MatthewBoeding/GPSboard/README.md

# GPS Board v3.0 r1.1

This board was designed for ECEN-435 at the University of Nebraska-Lincoln (Scott Campus).

## Connections

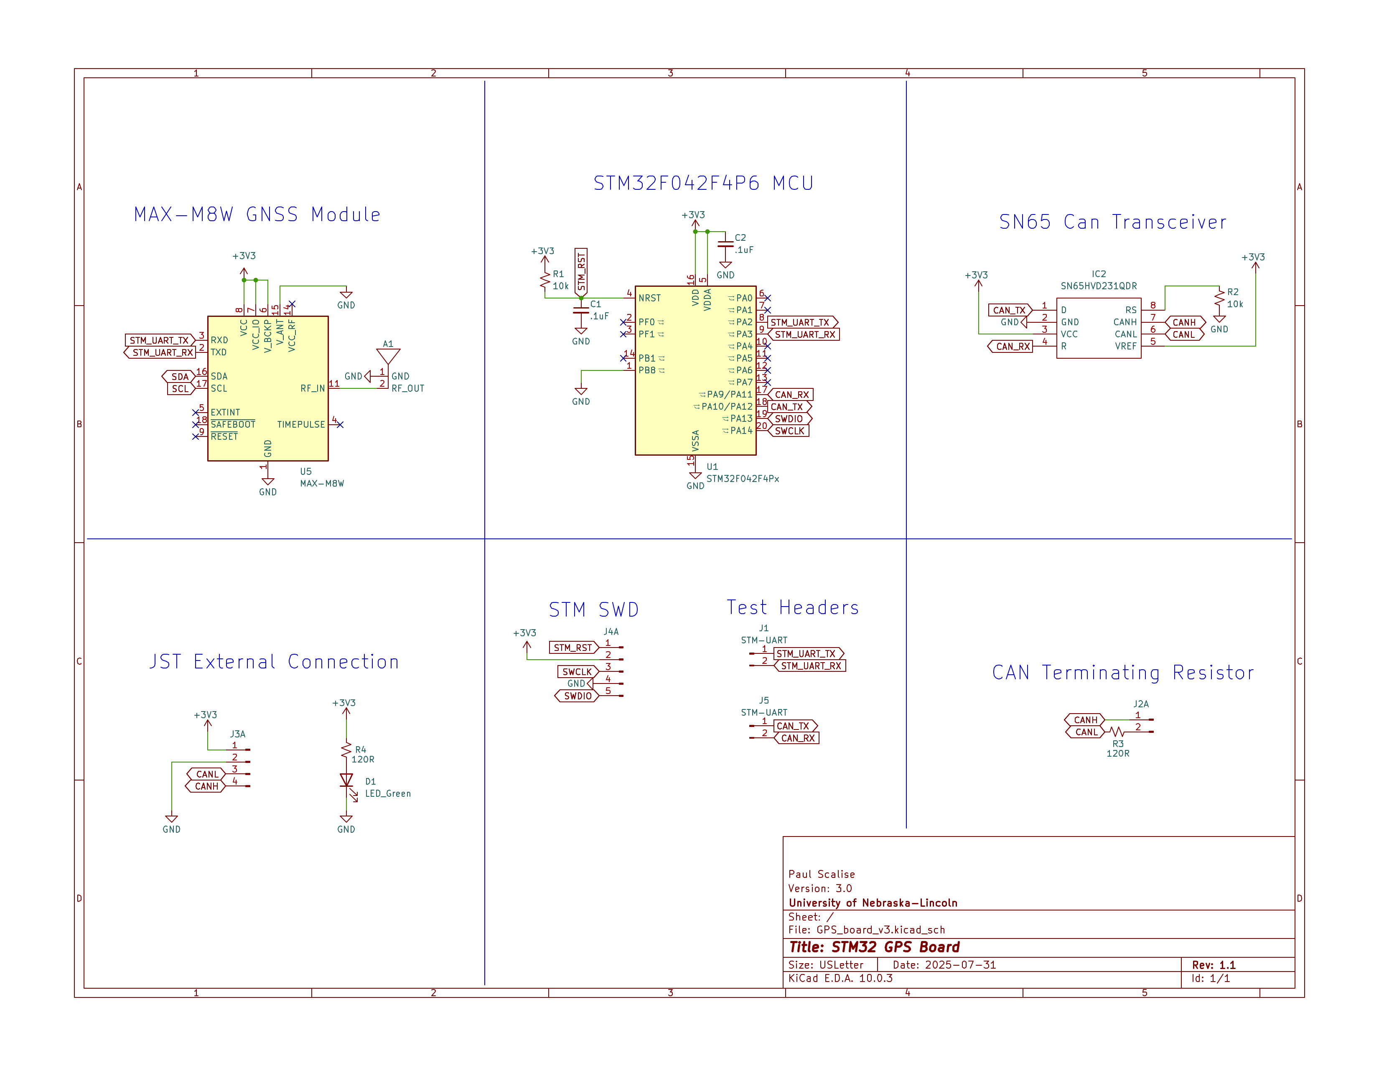
[picture p1: assets/sch.png]
schematic


## Board

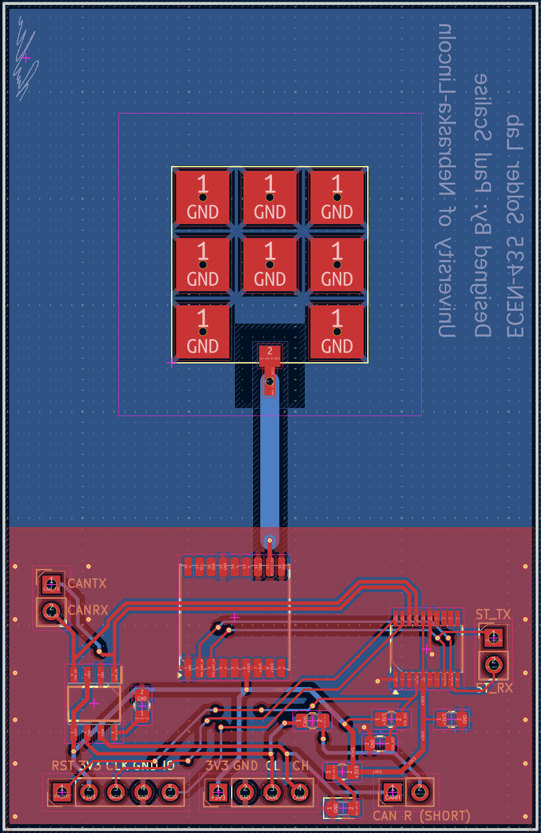
[picture p2: assets/board.png]
board


## Issues and Troubleshooting
Testing is underway with more updates to come.
