MatthewBoeding/GPSboard/Version2.0/README.md

# GPS Board V2.0
This board was designed for ECEN-4350 at the University of Nebraska-Lincoln (Scott Campus), so I will not be updating once completed. 
If a new design is required in the future, I will place it here. 
R1-R3 = 1kΩ, L2 = 5.6nH, C1 = 0Ω, C2 = 1.8 pF, C3 = 1µF

## Connections
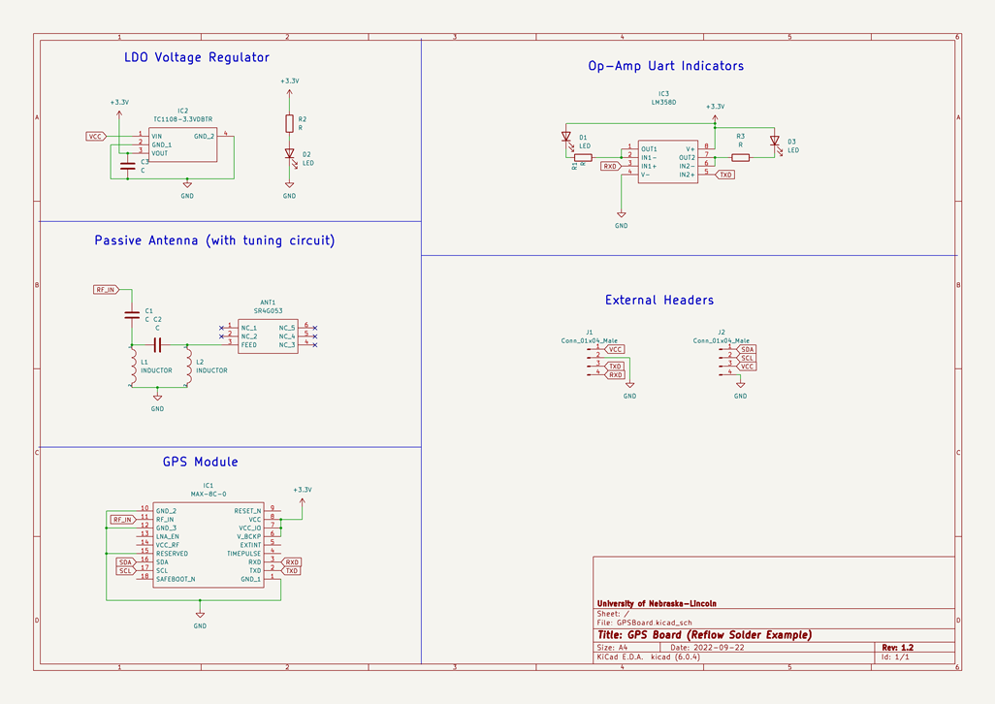
[picture p3: Version2.0/gps.schematic.png]
Schematic


## Issues and Troubleshooting
Version 1.0 board had issues with CAN communication. If this design is reused, will need to add on an LDO and allow for 5.0V to troubleshoot CAN transmission errors.
