MatthewBoeding/GPSboard/Hardware Design/GPS_board_v3.kicad_pcb

## KiCad design Hardware Design/GPS_board_v3.kicad_pcb (2026-06-24)

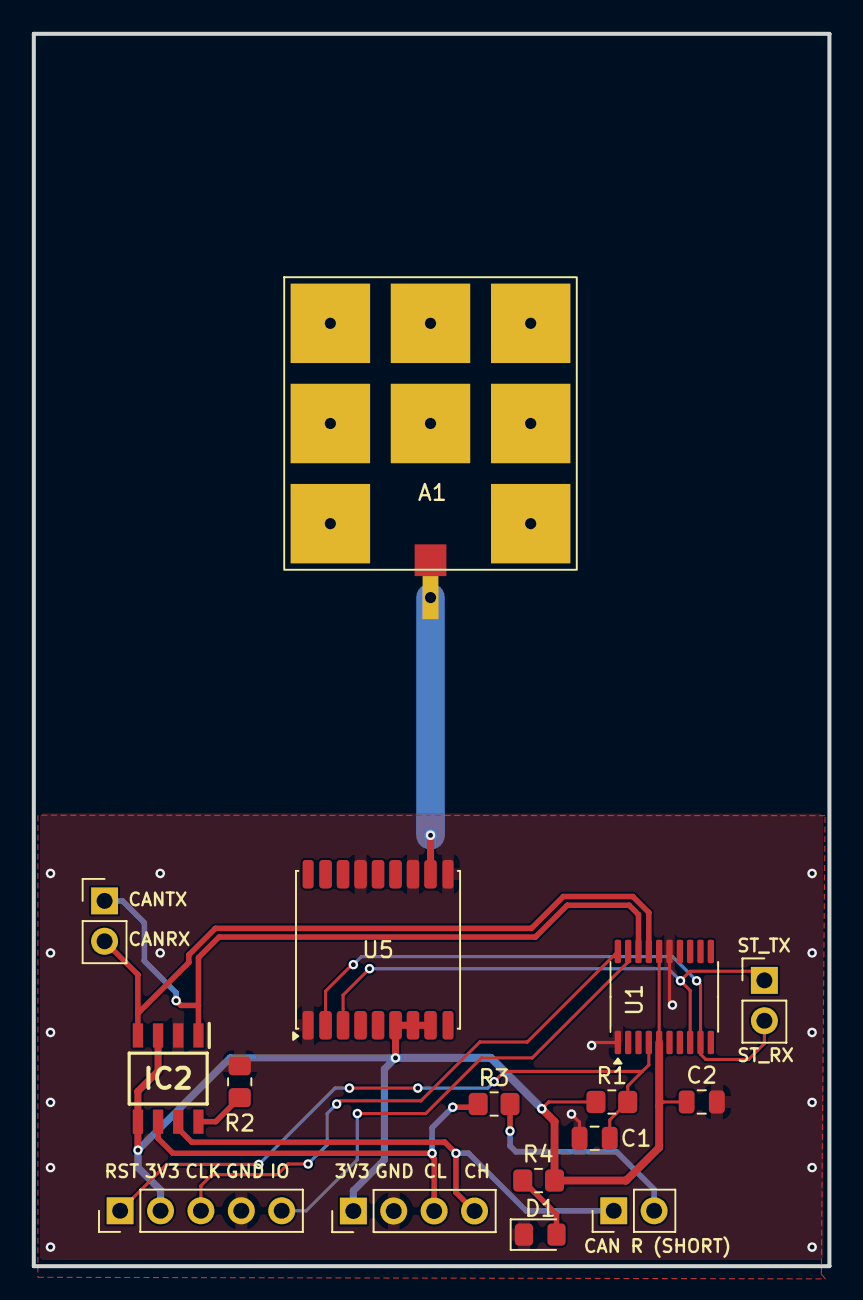
[picture p5: board GPS_board_v3.kicad_pcb from above]

Board: 2 copper layers, 50.0 x 77.5 mm, 16 parts (0 on the bottom side), 15 nets.

Parts:
A1: L000953-01
C1, C2: .1uF; C_0805_2012Metric
D1: LED_Green; LED_0805_2012Metric_Pad1.15x1.40mm_HandSolder
IC2: SN65HVD231QDR; SOIC127P600X175-8N
J1, J5: STM-UART; PinHeader_1x02_P2.54mm_Vertical
J2: PinHeader_1x02_P2.54mm_Vertical
J3: PinHeader_1x04_P2.54mm_Vertical
J4: PinHeader_1x05_P2.54mm_Vertical
R1, R2: 10k; R_0805_2012Metric_Pad1.20x1.40mm_HandSolder
R3, R4: 120R; R_0805_2012Metric_Pad1.20x1.40mm_HandSolder
U1: STM32F042F4Px; TSSOP-20_4.4x6.5mm_P0.65mm
U5: MAX-M8W; ublox_MAX

Connections:
+3V3: C2.1, IC2.3 (VCC), IC2.5 (VREF), J3.1, J4.2, R1.1, R4.2, U1.5 (VDDA), U1.16 (VDD), U5.6 (V_BCKP), U5.7 (VCC_IO), U5.8 (VCC)
CANH: IC2.7 (CANH), J2.1, J3.4
CANL: IC2.6 (CANL), J3.3, R3.1
CAN_RX: IC2.4 (R), J5.2, U1.17 (PA9/PA11)
CAN_TX: IC2.1 (D), J5.1, U1.18 (PA10/PA12)
GND: A1.1 (GND), C1.2, C2.2, D1.1 (K), IC2.2 (GND), J3.2, J4.4, R2.2, U1.1 (PB8), U1.15 (VSSA), U5.1 (GND), U5.10 (GND), U5.12 (GND), U5.15 (V_ANT)
unnamed: A1.2 (RF_OUT), U5.11 (RF_IN)
unnamed: D1.2 (A), R4.1
unnamed: IC2.8 (RS), R2.1
unnamed: J2.2, R3.2
STM_RST: C1.1, J4.1, R1.2, U1.4 (NRST)
STM_UART_RX: J1.2, U1.9 (PA3), U5.2 (TXD)
STM_UART_TX: J1.1, U1.8 (PA2), U5.3 (RXD)
SWCLK: J4.3, U1.20 (PA14)
SWDIO: J4.5, U1.19 (PA13)
