MatthewBoeding/GPSboard/Version2.0/GPSBoard.kicad_pcb

## KiCad design Version2.0/GPSBoard.kicad_pcb (2022-09-22)

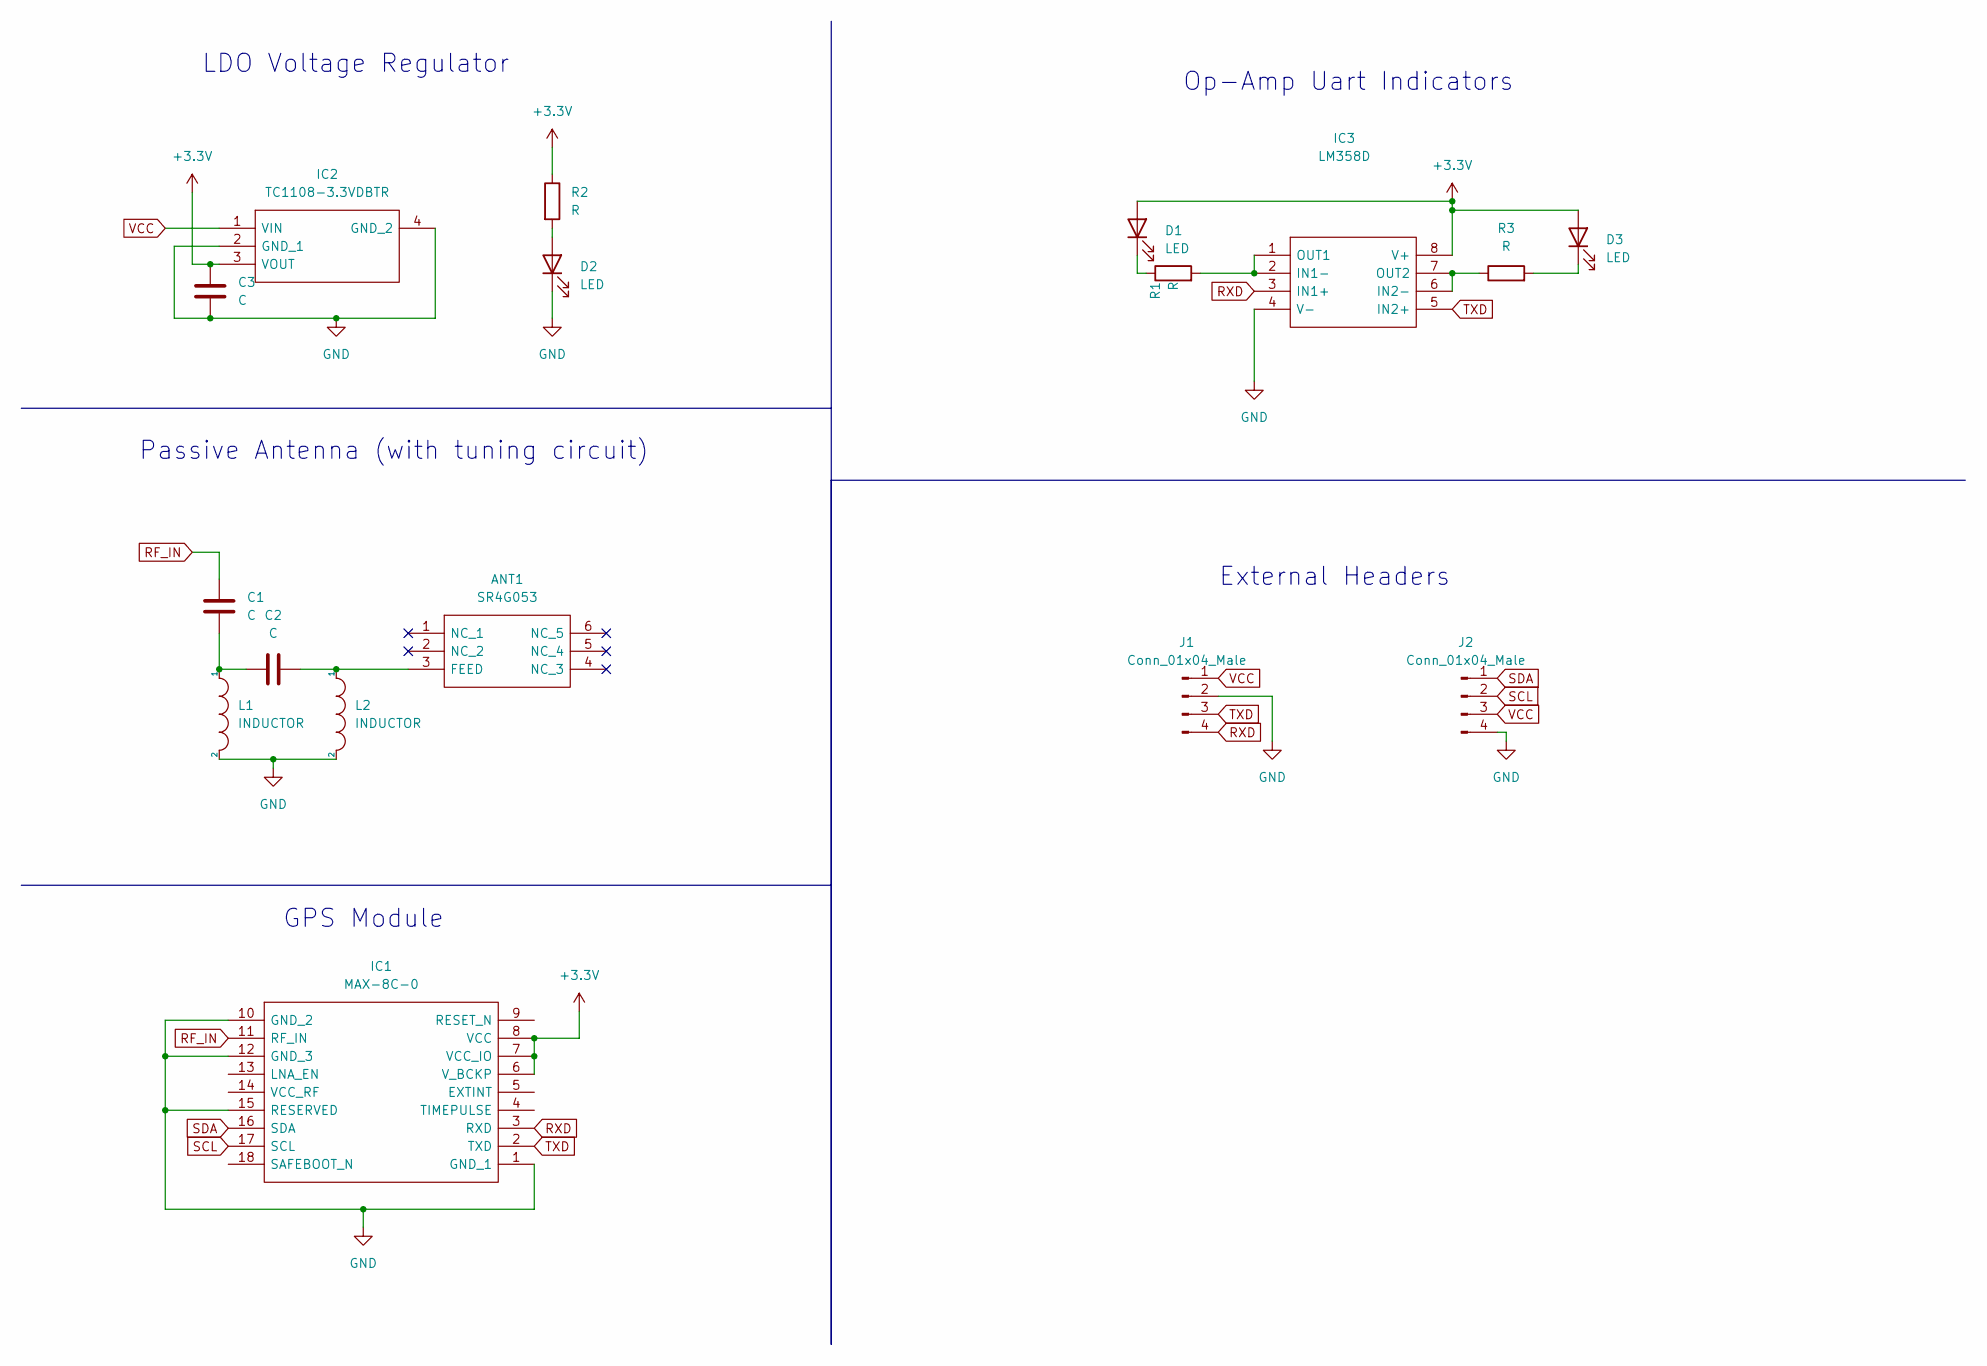
[picture p6: schematic GPSBoard.kicad_sch, GPS Board (Reflow Solder Example)]

Parts:
ANT1: SR4G053; Mouser Part Number 237-SR4G053
C1, C2, C3: C; R_0805_2012Metric
D1, D2, D3: LED; LED_0805_2012Metric
IC1: MAX-8C-0; MAX8C0; Mouser Part Number 377-MAX-8C-0
IC2: TC1108-3.3VDBTR; SOT230P700X180-4N; Mouser Part Number 579-TC1108-3.3VDBTR
IC3: LM358D; SOIC127P600X175-8N; Mouser Part Number 595-LM358D
J1, J2: Conn_01x04_Male; PinHeader_1x04_P2.54mm_Vertical
L1, L2: INDUCTOR; R_0805_2012Metric
R1, R2, R3: R; R_0805_2012Metric

Connections:
+3V3: C3.1, D1.2 (A), D3.2 (A), IC1.6 (V_BCKP), IC1.7 (VCC_IO), IC1.8 (VCC), IC2.3 (VOUT), IC3.8 (V+), R2.1
GND: C3.2, D2.1 (K), IC1.1 (GND_1), IC1.10 (GND_2), IC1.12 (GND_3), IC1.15 (RESERVED), IC2.2 (GND_1), IC2.4 (GND_2), IC3.4 (V-), J1.2, J2.4, L1.2, L2.2
unnamed: ANT1.3 (FEED), C2.2, L2.1
unnamed: C1.2, C2.1, L1.1
unnamed: D2.2 (A), R2.2
unnamed: D3.1 (K), R3.2
unnamed: IC3.1 (OUT1), IC3.2 (IN1-), R1.2
unnamed: IC3.6 (IN2-), IC3.7 (OUT2), R3.1
unnamed: D1.1 (K), R1.1
RF_IN: C1.1, IC1.11 (RF_IN)
RXD: IC1.3 (RXD), IC3.3 (IN1+), J1.4
SCL: IC1.17 (SCL), J2.2
SDA: IC1.16 (SDA), J2.1
TXD: IC1.2 (TXD), IC3.5 (IN2+), J1.3
VCC: IC2.1 (VIN), J1.1, J2.3

Notes on the sheet:
Passive Antenna (with tuning circuit)
GPS Module
LDO Voltage Regulator
Op-Amp Uart Indicators
External Headers

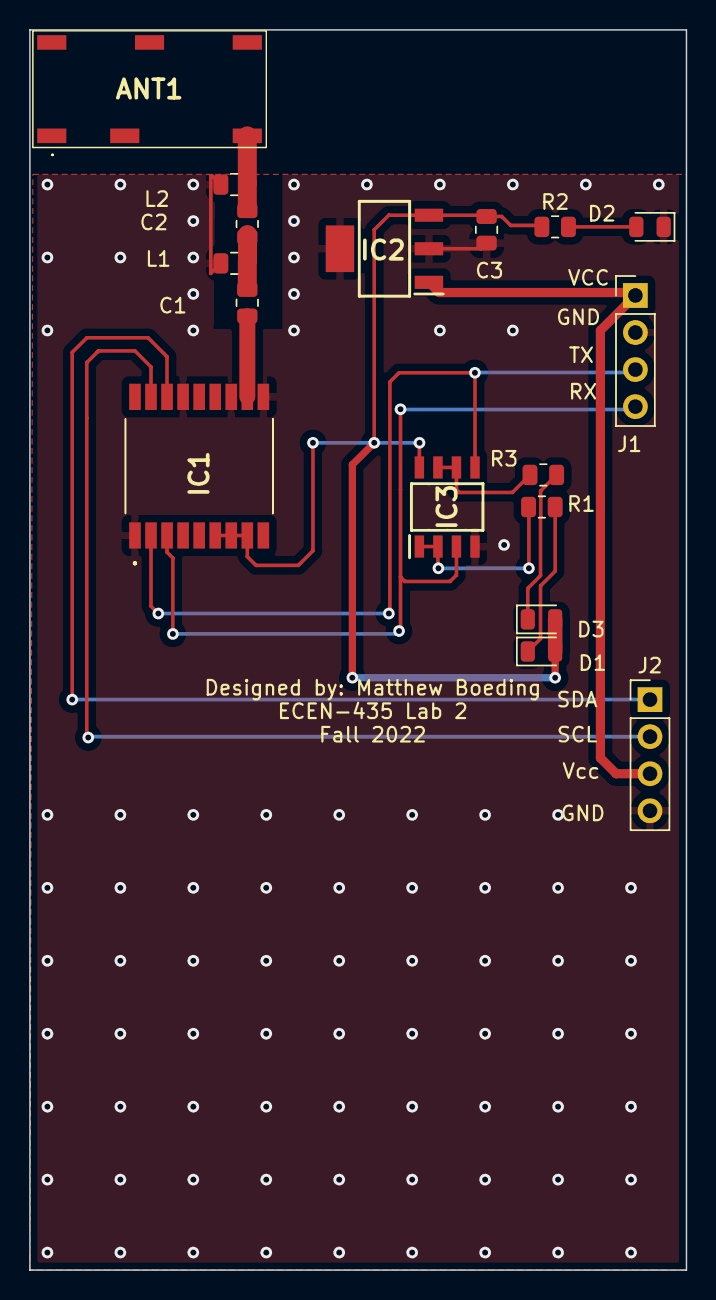
[picture p7: board GPSBoard.kicad_pcb from above]

Board: 2 copper layers, 45.0 x 85.0 mm, 17 parts (0 on the bottom side), 15 nets.
