MatthewBoeding/GPSboard/Firmware/STM_GPS_BOARD/Core/Src/main.c

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
/* Includes ------------------------------------------------------------------*/
#include "main.h"

/* USER CODE BEGIN Includes */
#include <string.h>
#include <stdbool.h>
/* USER CODE END Includes */

CAN_HandleTypeDef hcan;

TIM_HandleTypeDef htim14;

UART_HandleTypeDef huart2;

/* USER CODE BEGIN PV */
uint8_t uart_rx_buf[128] = {0};
volatile bool measure_flag = false;
uint8_t frameBuffer[100];
uint8_t lat[8];
uint8_t lon[8];
uint8_t fixedlat[8] = {"LA00.00N"};
uint8_t fixedlon[8] = {"LO000.0E"};

uint8_t gpsOn[8]       = {0xB5,0x62,0x06,0x57,0x00,0x00,0x5D,0x1D};
uint8_t pwrControl[16] = {0xB5,0x62,0x06,0x86,0x08,0x00,0x00,0x03,0x00,0x00,0x00,0x00,0x00,0x00,0x97,0x6F};
uint8_t pwrControl2[8] = {0xB5,0x62,0x06,0x86,0x00,0x00,0x8C,0xAA};
uint8_t coldRestart[12]= {0xB5,0x62,0x06,0x04,0x04,0x00,0xFF,0xFF,0x02,0x00,0x0E,0x61};
/* USER CODE END PV */

void SystemClock_Config(void);
static void MX_GPIO_Init(void);
static void MX_CAN_Init(void);
static void MX_USART2_UART_Init(void);
static void MX_TIM14_Init(void);
/* USER CODE BEGIN PFP */
static void gpsCommand(const uint8_t *d, uint8_t len);
static uint8_t uartRecv(void);
static void uartWrite(uint8_t b);
static uint8_t getFrame(void);
static void processFrame(uint8_t size);
static void CAN_Send8(const uint8_t *payload8, uint16_t std_id);
/* USER CODE END PFP */

/* USER CODE BEGIN 0 */
void HAL_TIM_PeriodElapsedCallback(TIM_HandleTypeDef *htim)
{
  if (htim->Instance == TIM14) {
    measure_flag = true;
  }
}
/* USER CODE END 0 */

/**
  * @brief  The application entry point.
  * @retval int
  */
int main(void)
{

  /* MCU Configuration--------------------------------------------------------*/

  /* Reset of all peripherals, Initializes the Flash interface and the Systick. */
  HAL_Init();

  /* Configure the system clock */
  SystemClock_Config();

  /* Initialize all configured peripherals */
  MX_GPIO_Init();
  MX_CAN_Init();
  MX_USART2_UART_Init();
  MX_TIM14_Init();
  /* USER CODE BEGIN 2 */

  HAL_CAN_Start(&hcan);

  // Configure an accept-all CAN filter into FIFO0
  CAN_FilterTypeDef f = {0};
  f.FilterBank = 0;
  f.FilterMode = CAN_FILTERMODE_IDMASK;
  f.FilterScale = CAN_FILTERSCALE_32BIT;
  f.FilterIdHigh = 0x0000;
  f.FilterIdLow  = 0x0000;
  f.FilterMaskIdHigh = 0x0000;
  f.FilterMaskIdLow  = 0x0000;
  f.FilterFIFOAssignment = CAN_FILTER_FIFO0;
  f.FilterActivation = ENABLE;
  HAL_CAN_ConfigFilter(&hcan, &f);

  // 4s interrupt to get new coordinates
  HAL_TIM_Base_Start_IT(&htim14);

  // Initialize GPS (MAX-M8C-0)
  gpsCommand(gpsOn,       sizeof(gpsOn));
  gpsCommand(pwrControl,  sizeof(pwrControl));
  gpsCommand(pwrControl2, sizeof(pwrControl2));
  gpsCommand(coldRestart, sizeof(coldRestart));
  /* USER CODE END 2 */

  /* Infinite loop */
  /* USER CODE BEGIN WHILE */
  while (1) {
    if (measure_flag) {
      measure_flag = false;

      uint8_t n = getFrame();
      if (n > 0) {
        processFrame(n);
        // Send two 8-byte frames with the lat/lon strings
        CAN_Send8(lat, 0x101);
        CAN_Send8(lon, 0x101);
      }
    }
    /* USER CODE END WHILE */

    /* USER CODE BEGIN 3 */
  }
  /* USER CODE END 3 */
}

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
/* USER CODE BEGIN 4 */
static void gpsCommand(const uint8_t *d, uint8_t len)
{
  HAL_UART_Transmit(&huart2, (uint8_t*)d, len, HAL_MAX_DELAY);
}

static void uartWrite(uint8_t b)
{
  HAL_UART_Transmit(&huart2, &b, 1, HAL_MAX_DELAY);
}

__inline static uint8_t uartRecv(void)
{
  uint8_t b;
  HAL_UART_Receive(&huart2, &b, 1, 100);
  return b;
}

static uint8_t getFrame(void)
{
  uint8_t frameSize = 0;
  bool receive = true, gotHeader = false;
  uint8_t hdr[5];

  while (receive) {
    while (!gotHeader) {
      uint8_t c = uartRecv();
      if (c == '$') {
        for (int i = 0; i < 5; i++){
        	hdr[i] = uartRecv();
        }
        gotHeader = (hdr[0]=='G' && hdr[1]=='N' && hdr[2]=='G' && hdr[3]=='L' && hdr[4]=='L');
      }
    }
    uint8_t c = uartRecv();
    if (c == '$') {
      receive = false;
    } else {
      if (frameSize < sizeof(frameBuffer)) frameBuffer[frameSize++] = c;
    }
  }
  return frameSize;
}

static void processFrame(uint8_t size)
{
  uint8_t commas[7] = {0};
  int i = 0, j = 0;

  while (i < 7 && j < size) {
      if (frameBuffer[j] == ',') {
          commas[i++] = j;
      }
      j++;
  }

  if (i < 6 || frameBuffer[commas[5] + 1] == 'V' || (commas[1] - commas[0] < 2)) {
    memcpy(lat, fixedlat, sizeof(lat));
    memcpy(lon, fixedlon, sizeof(lon));
    return;
  }

  // LAT: "LA00.00N" from ddmm.mmmm,N/S
  lat[0]='L'; lat[1]='A';
  lat[2] = frameBuffer[commas[0] + 1];
  lat[3] = frameBuffer[commas[0] + 2];
  lat[4] = '.';
  lat[5] = frameBuffer[commas[0] + 3];
  lat[6] = frameBuffer[commas[0] + 4];
  lat[7] = frameBuffer[commas[1] + 1];

  // LON: "LO000.0E" from dddmm.mmmm,E/W
  lon[0]='L'; lon[1]='O';
  lon[2] = frameBuffer[commas[2] + 1];
  lon[3] = frameBuffer[commas[2] + 2];
  lon[4] = frameBuffer[commas[2] + 3];
  lon[5] = '.';
  lon[6] = frameBuffer[commas[2] + 4];
  lon[7] = frameBuffer[commas[3] + 1];
}

static void CAN_Send8(const uint8_t *payload8, uint16_t std_id)
{
  CAN_TxHeaderTypeDef hdr;
  hdr.StdId = std_id;
  hdr.ExtId = 0;
  hdr.IDE   = CAN_ID_STD;
  hdr.RTR   = CAN_RTR_DATA;
  hdr.DLC   = 8;
  hdr.TransmitGlobalTime = DISABLE;

  uint32_t mb;
  HAL_CAN_AddTxMessage(&hcan, &hdr, (uint8_t*)payload8, &mb);
}
/* USER CODE END 4 */
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
