MatthewBoeding/GPSboard/(commit log)

2021-07-23 Initial framework started
    Can't download newest XC compiler, but last version appears to work
2021-07-23 Timer Hardware Testing
    Ready to start on LCD library as well.
2021-07-29 Ready for LCD test
    Will write the rest of the handler after GPS board is running.
2021-07-29 Fixed casting/mismatching data types
    [main.c]
2021-07-29 SPI rework
2021-08-12 Console for debugging. NMEA frame processing
2021-09-22 Working Board
2021-09-22 Include Schematic
2022-09-22 Updated Version
    [GPSBoard.csv, GPSBoard.kicad_pcb, GPSBoard.kicad_sch]
2022-09-22 Schematic Annotation Issues
2025-07-03 init commit
    [GPSBoard.csv, GPSBoard.kicad_pcb, GPSBoard.kicad_sch, GPS_board_v3.kicad_pcb, GPS_board_v3.kicad_sch]
2025-07-03 add bom
    [GPS_board_v3.kicad_pcb, bom.csv]
2025-07-04 Preserve Old Version Assets
    [GPSBoard.csv, GPSBoard.kicad_pcb, GPSBoard.kicad_sch]
2025-07-31 redesigned board for STM32
    [GPS_board_v3-B_Cu.gbr, GPS_board_v3-B_Mask.gbr, GPS_board_v3-B_Paste.gbr, GPS_board_v3-B_Silkscreen.gbr, GPS_board_v3-Edge_Cuts.gbr, GPS_board_v3-F_Cu.gbr, GPS_board_v3-F_Mask.gbr, GPS_board_v3-F_Paste.gbr]
2025-07-31 fixed gerbers & bom
    [GPS_board_v3-B_Cu.gbr, GPS_board_v3-B_Mask.gbr, GPS_board_v3-B_Paste.gbr, GPS_board_v3-B_Silkscreen.gbr, GPS_board_v3-Edge_Cuts.gbr, GPS_board_v3-F_Cu.gbr, GPS_board_v3-F_Mask.gbr, GPS_board_v3-F_Paste.gbr]
2026-08-20 updated price in bom
    [bom.csv, bom.xlsx]
