MatthewBoeding/GPSboard/(notices)

Notices in the files:
Firmware/STM_GPS_BOARD/Core/Src/main.c:
Copyright (c) 2025 STMicroelectronics.
All rights reserved.
This software is licensed under terms that can be found in the LICENSE file
